brackendawson/ChristmasLights/msp430/USI_State_Machine.odt

ChristmasLights USI State Machine

This is the state machine for controlling the MSP430 hardware USI for the ChristmasLights program.

# State Diagram

A transition will happen every time that send() is called. States represent the activity of the USI hardware, software acts on transitions.

IDLE TXBLUE TXGREEN

Software calls send()

USI ISR calls send() and there are no more LEDs to transmit to.

TXRED

USI ISR calls send() and there are more LEDs to transmit to.

USI ISR calls send()

USI ISR calls send()

# Send()

## IDLE

In this state, send() can only have been called by user code. In this state send() shall:

1. Set led_index to 0.
2. Ask the pattern code for the colour of led[index] and load bits 16 to 23 into USISRL.
3. Enable the USI interrupt by setting USIIE.
4. Write “8” into USICNT to begin transmitting the red value.
5. Move the state machine to TXRED.

It is essential that user code does not call send() again until the USI state machine has returned to idle.

## TXRED

In this state send() should only have been called by the USI Interrupt Service Routine when the USI finished sending the last 8 bits. In this state send() shall:

1. Ask the pattern code for the colour of led[index] and load bits 8 to 15 into USISRL.
2. Write “8” into USICNT to begin transmitting the green value.
3. Move the state machine to TXGREEN.

## TXGREEN

In this state send() should only have been called by the USI Interrupt Service Routine when the USI finished sending the last 8 bits. In this state send() shall:

1. Ask the pattern code for the colour of led[index] and load bits 0 to 7 into USISRL.
2. Write “8” into USICNT to begin transmitting the blue value.
3. Move the state machine to TXBLUE.

## TXBLUE

In this state send() should only have been called by the USI Interrupt Service Routine when the USI finished sending the last 8 bits. In this state send() shall:

1. Increment led_index.
2. If led_index is beyond the least LED in the string:
  1. Disable the USI interrupt by clearing USIIE.
  2. Move the state machine to IDLE.
3. Else:
  1. Ask the pattern code for the colour of led[index] and load bits 16 to 23 into USISRL.
  2. Write “8” into USICNT to begin transmitting the red value.
  3. Move the state machine to TXRED.
