brackendawson/ChristmasLights/msp430/hardware/schematic.sch

## KiCad design msp430/hardware/schematic.sch (2012-12-22)

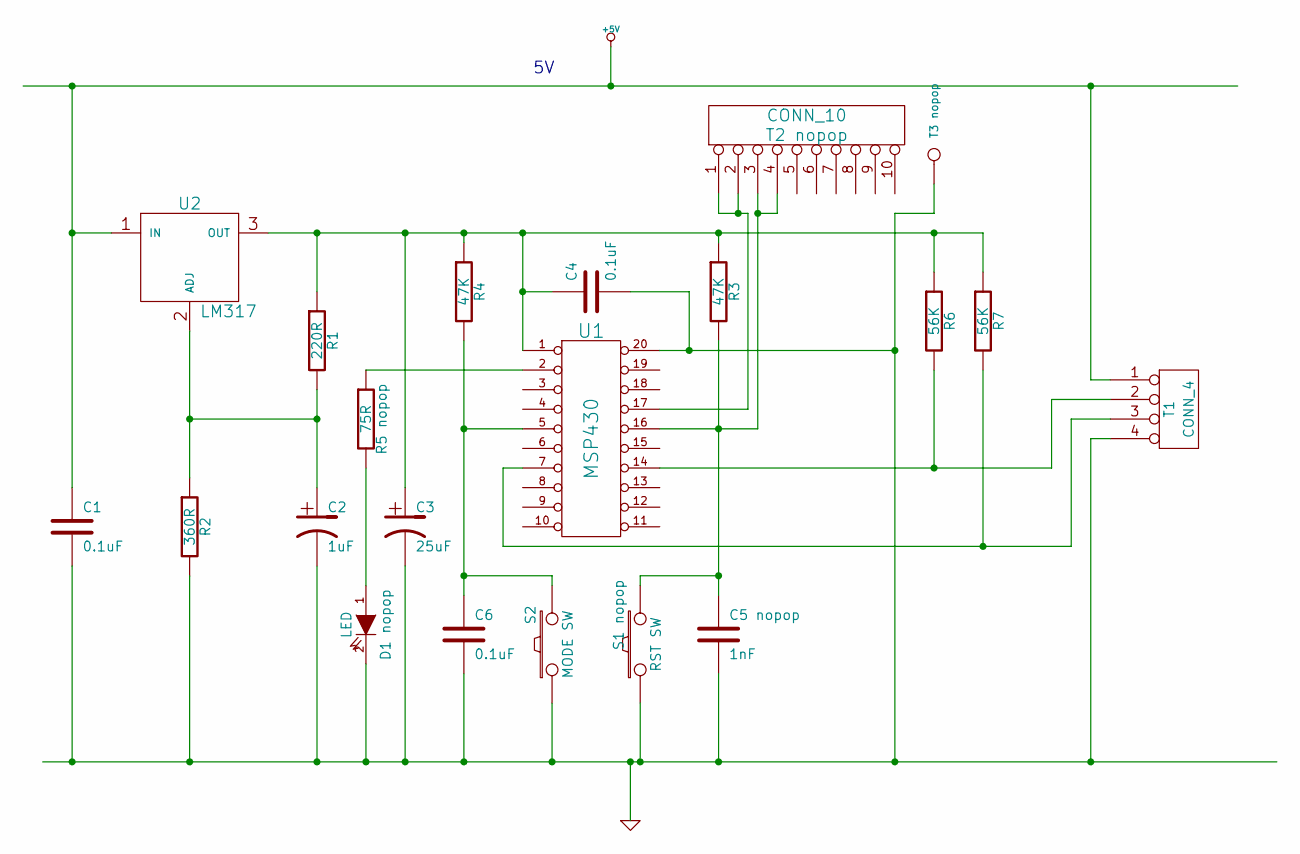
[picture p1: schematic schematic.sch]

Parts:
C1, C4, C6: 0.1uF
C2: 1uF
C3: 25uF
C5~nopop: 1nF
D1~nopop: LED
R1: 220R
R2: 360R
R3, R4: 47K
R5~nopop: 75R
R6, R7: 56K
S1~nopop: RST SW
S2: MODE SW
T1: CONN_4
T2~nopop: CONN_10
T3~nopop: CONN_1
U1: MSP430
U2: LM317

Connections:
+5V: C1.1, T1.1, U2.1 (IN)
GND: C1.2, C2.2, C3.2, C4.2, C5~nopop.2, C6.2, D1~nopop.2 (K), R2.2, S1~nopop.1, S2.1, T1.4, T3~nopop.1, U1.20
unnamed: C2.1, R1.2, R2.1, U2.2 (ADJ)
unnamed: C3.1, C4.1, R1.1, R3.1, R4.1, R6.1, R7.1, U1.1, U2.3 (OUT)
unnamed: C5~nopop.1, R3.2, S1~nopop.2, T2~nopop.3, T2~nopop.4, U1.16
unnamed: C6.1, R4.2, S2.2, U1.5
unnamed: D1~nopop.1 (A), R5~nopop.2
unnamed: R5~nopop.1, U1.2
unnamed: R6.2, T1.2, U1.14
unnamed: R7.2, T1.3, U1.7
unnamed: T2~nopop.1, T2~nopop.2, U1.17
