brackendawson/ChristmasLights/tetris.h

#define TETRIS_GAP 10
#define TETRIS_PIECES NUM_LEDS/TETRIS_GAP
#define TETRIS_LARGEST 4

typedef struct {
  uint8_t len;
  uint8_t col;
  uint8_t pos;
} tetris_piece;

static tetris_piece (*tetris_pieces)[TETRIS_PIECES] = (tetris_piece(*)[TETRIS_PIECES]) &common_buffer;
static_assert(sizeof(*tetris_pieces) <= sizeof(common_buffer), "tetris_pieces must fit in common_buffer");
uint8_t tetris_div;
uint8_t tetris_gap;

void tetris_init(void) {
  (*tetris_pieces)[0].col = random(RED,INDIGO+1);
  (*tetris_pieces)[0].len = random(1,TETRIS_LARGEST+1);
  (*tetris_pieces)[0].pos = NUM_LEDS;
  for (uint8_t i = 1; i < TETRIS_PIECES; i++) {
    (*tetris_pieces)[i].pos = 0;
  }
  tetris_div = 0;
  tetris_gap = 0;
  return;
}

void tetris_frame(void) {
  //only run twice a second
  if (tetris_div++ < 12) {
    return;
  }
  tetris_div = 0;

  //move pieces down
  for (uint8_t i = 0; i < TETRIS_PIECES; i++) {
    if ((*tetris_pieces)[i].pos == 0) {
      continue;
    }
    (*tetris_pieces)[i].pos--;
  }

  //spawn a piece if we can
  if (tetris_gap >= TETRIS_GAP) {
    for (uint8_t i = 0; i < TETRIS_PIECES; i++) {
      if ((*tetris_pieces)[i].pos > 0) {
        continue;
      }
      (*tetris_pieces)[i].col = random(RED,INDIGO+1);
      (*tetris_pieces)[i].len = random(1,TETRIS_LARGEST+1);
      (*tetris_pieces)[i].pos = NUM_LEDS;
      tetris_gap = 0;
      break;
    }
  } else {
    tetris_gap++;
  }

  return;
}

rgb24 tetris_getled(uint8_t led) {
  led += 1;
  for (uint8_t i = 0; i < TETRIS_PIECES; i++) {
    if ((*tetris_pieces)[i].pos == 0) {
      continue;
    }
    if (led < (*tetris_pieces)[i].pos) {
      continue;
    }
    if (led > (*tetris_pieces)[i].pos + (*tetris_pieces)[i].len - 1) {
      continue;
    }
    return colour((*tetris_pieces)[i].col, 99);
  }
  return (rgb24) {0x00,0x00,0x00};
}
