brackendawson/ChristmasLights/(commit log)

2012-11-27 Fist commit
    Just after sucessful test of string with 7 LED rainbow
2012-12-04 Space saving and cleanup
    Use three unsigned chars for RGB values.
    Handle registers in a more sane way that won't break and be
    impossible to debug.
    [main.c]
2012-12-06 Enable interrupts
    TimerA1 going for 25 times persecond.
    USI interrupt needs to be handled now.
    Optimisations set to s for size (like 2 but smaller).
2012-12-06 Use the right low power mode
    Need the DCO on.
2012-12-07 Totally interrupt driven animation MILESTONE
    Totally interrupt driven precession of lights. Next need to move
    it to a header and sort out multi modes.
2012-12-08 Add sctipt to generate sub-pixel lookup tables
    These allow fading of all colours. I must thank andybelov for this:
    http://arduino.cc/forum/index.php/topic,96839.0.html
2012-12-08 Minor fix in Makefile and code cleanup
    Casting there wasn't helping.
    Makefile wsa ignoring header.
    [colours.h]
2012-12-08 Increase DCO clock to maximim
    MORE POWAAAAA!
    DCO at about 25MHz, USI at about 10Mhz (others possible)
    I've calibrated based on my MSP, YMMV.
2012-12-08 Fix the colours at last
    I needed the bumped speed to do this.
    Colors are unsigned long, not unsigned int.
    Doing unary and binary operations in the same statement with array
    members too small for the operation turns out to be a bad idea.
    [colours.h, main.c]
2012-12-08 Improve colours
    Having only one 0 in each table seemed sensible but it's wrong. I
    did have to move the 0 to 1 boundaries around to sort of line up
    with the 255 table though to prevent flashed of primary colour
    before the LED turned off.
    Alse got the perl script to write all the code.
    [colours.h]
2012-12-12 File structure for multi pattern
    That went well, now watch this.
    [configuration.h]
2012-12-12 Move pattern headers into directory
    [configuration.h]
2012-12-12 Free up pin P1.7
    There is no input from the string.
2012-12-12 Move timer calibration to configuration.h
    [configuration.h]
2012-12-12 Working multi patterns
    Currently just two patterns plus static and cycle.
    Moved to a bigger MCU, used more standard timer register
    definitions to support this, nice to see the new chip's DCO spins
    about as fast.
    [configuration.h]
2012-12-16 Add run pattern
    written at southackton in about 10 minutes.
    [configuration.h]
2012-12-16 Fix race condition
    No more frames before the pattern is ready.
    [main.c]
2012-12-16 Remove shared buffer and fix missing init
    No point sharing that buffer RAM use was tiny.
    Made the pattens start from the same place, carful with those
    uninitialised values.
    [configuration.h]
2012-12-16 Fix compiler warning
    [configuration.h]
2012-12-17 Add chameleon pattern
    [configuration.h]
2012-12-17 Add wave function
    [configuration.h]
2012-12-17 Tidy up, better comments, can set NUM_LEDS
    NUM_LEDS can be set up to 255 and all patterns tolerate.
    Better commants, patterns/fadeall is the turorial.
    [configuration.h]
2012-12-17 More cleanup
    This is about the quality I'd be happy to share now.
    [configuration.h]
2012-12-17 Add reminder to set mmcu in Makefile
    Reminder in configuration.h
    [configuration.h]
2012-12-17 Add twinkle pattern
    And a perl script to make pre-computed randomness.
    [configuration.h]
2012-12-17 Set CYCLE_TIME to 5 minutes
    [configuration.h]
2012-12-19 Fix bug in timers & red led on slow frame code
    Now does count timer wraps while running frame code.
    [main.c]
2012-12-20 Add hardware schamatic
    Use Kickad
    [schematic.sch]
2012-12-22 Add veroboard Layout
    It's a spreadsheet, hardware is now tested and working.
    [Veroboard_Laybout.ods, configuration.h, schematic.sch]
2012-12-26 Give the run pattern a tail
    9 progressively dimmer LEDs follow the first up the tree.
2013-05-21 That's index, not brightness
    fixes #3
    [configuration.h]
2013-11-16 Initial fork to arduino
    It compiles for an Uno. It is untested. The buttons dont work yet.
    [configuration.h]
2013-11-16 Make it work on Leonardo
    [configuration.h]
2013-11-16 Initial attempt at arduino implementation using fastspi_led.
2013-11-16 Fix <= checks on unsigned values.
    [chameleon.h, fade.h]
2013-11-16 Reset counters so they don't trigger again immediatelly
    [ChristmasLights.ino]
2013-11-16 Rename to avoid arduino ide seeing it.
2013-11-17 Create gltest for easier debugging and make it empty for arduino ide
2013-11-17 Remove unused code.
    [configuration.h]
2013-11-17 Add delay to make sure send is complete and replace init() => pattern_init().
    And ensure pattern_init() is called at setup time.
    [ChristmasLights.ino]
2013-11-18 Simplify pattern configuration.
    [configuration.h]
2013-11-18 Add pacman pattern.
    [configuration.h]
2013-11-18 Add firework pattern.
    [configuration.h]
2013-11-18 Make it compile on gcc-msp430 and arduino
    [Veroboard_Laybout.ods, configuration.h, schematic.sch]
2013-11-18 Update readme for arduino
2013-11-20 Fix init calls that should be pattern_init().
    [gltest.c]
2013-11-20 Help @brackendawson by avoiding the tricky maths.
    [firework.h]
2013-11-20 Half string clock and impliment button
    [configuration.h]
2013-11-20 Tie in CYCLE_TIME config option to arduino
2013-11-20 Cleanup config file and comments
    [configuration.h]
2013-11-20 Impliment random() on msp340
    also fix minor bug in firework.
    [configuration.h]
2013-11-20 Add colour twinkle pattern
    [configuration.h]
2013-11-21 Fix uninitialized variable bug. Thanks to @Benjie.
    [firework.h]
2013-12-01 Fix button bug on MSP430
    That would have been disappointing.
    [main.c]
2013-12-11 Fix arduino instructions
    need to install FastSPI
2014-12-02 Make spacebar into "button"
2020-12-19 Avoid pauses in colourtwinkle
    It would frequently randomly change a light to the same colour.
    [colourtwinkle.h]
2020-12-19 Make the next pattern random in cycle mode
    [configuration.h]
2020-12-19 Upgrade FastSPI_LED 1.x library to FasLED 3.x
    All works in Arduino 1.8
    [configuration.h]
2020-12-19 Add a BRAND NEW pattern
    [configuration.h]
2020-12-20 Turms out 1D Tetris is ez
    [configuration.h]
2020-12-27 Fix mode button on msp430
    I don't know how that could have ever worked with interrupts all disabled (P1IE).
    [main.c]
2020-12-27 No need to overclock
    This calibration data exist for msp430g2452 but not the msp430g2231 or msp430g2211, probably have to guess with those, or go safe and aim for 8MHz.
2020-12-28 Honey I shrunk the binary
    It now runs with ALL patterns on an MSP430 with >=256B RAM.
    [configuration.h]
2020-12-28 avoid infinite loop with bad RNG
    Some random number generators aren't diverse enough to escape this loop. This is still random enough.
    [colourmorph.h]
2020-12-28 Fix Timer speeds for the new 16MHz MCLK.
    I don't know why or if I really chose 250µs for the internal timer, but we're sticking with it. I probably didn't do the math and just calibrated it instead. Now I'm using a chip with pre-calibrated 16MHz data I've done the math instead and it's perfect.
    [configuration.h]
2020-12-28 Enable the watchdog timer
    MSP430 only
    [configuration.h]
2020-12-28 Check structure sizes correctly
    [colourmorph.h, colourtwinkle.h, fade.h, static.h, tetris.h, twinkle.h, wave.h]
2020-12-28 improve docs in configuration
    [configuration.h]
2020-12-30 Further reduce RAM use
    [configuration.h]
2021-01-01 Add a slightly different firework
    [configuration.h]
2021-01-01 make wave much more efficient
    [configuration.h]
2021-01-01 Call getled fewer times
    fixes #2
    [main.c]
2021-01-02 new candle light pattern
    I tried to do this a very clever way, this simple way looked far better.
    [configuration.h]
2021-01-03 Use an rgb24 type rather than uint32_t
    Less bitshifting saved some program space. LED arrays will be smaller.
    [configuration.h]
